Maidui3-lab/robo-con-Wi-Fi/Hardware/robo-con-Wi-Fi/robo-con-Wi-Fi.kicad_pcb

## KiCad design Hardware/robo-con-Wi-Fi/robo-con-Wi-Fi.kicad_pcb (2026-10-29)

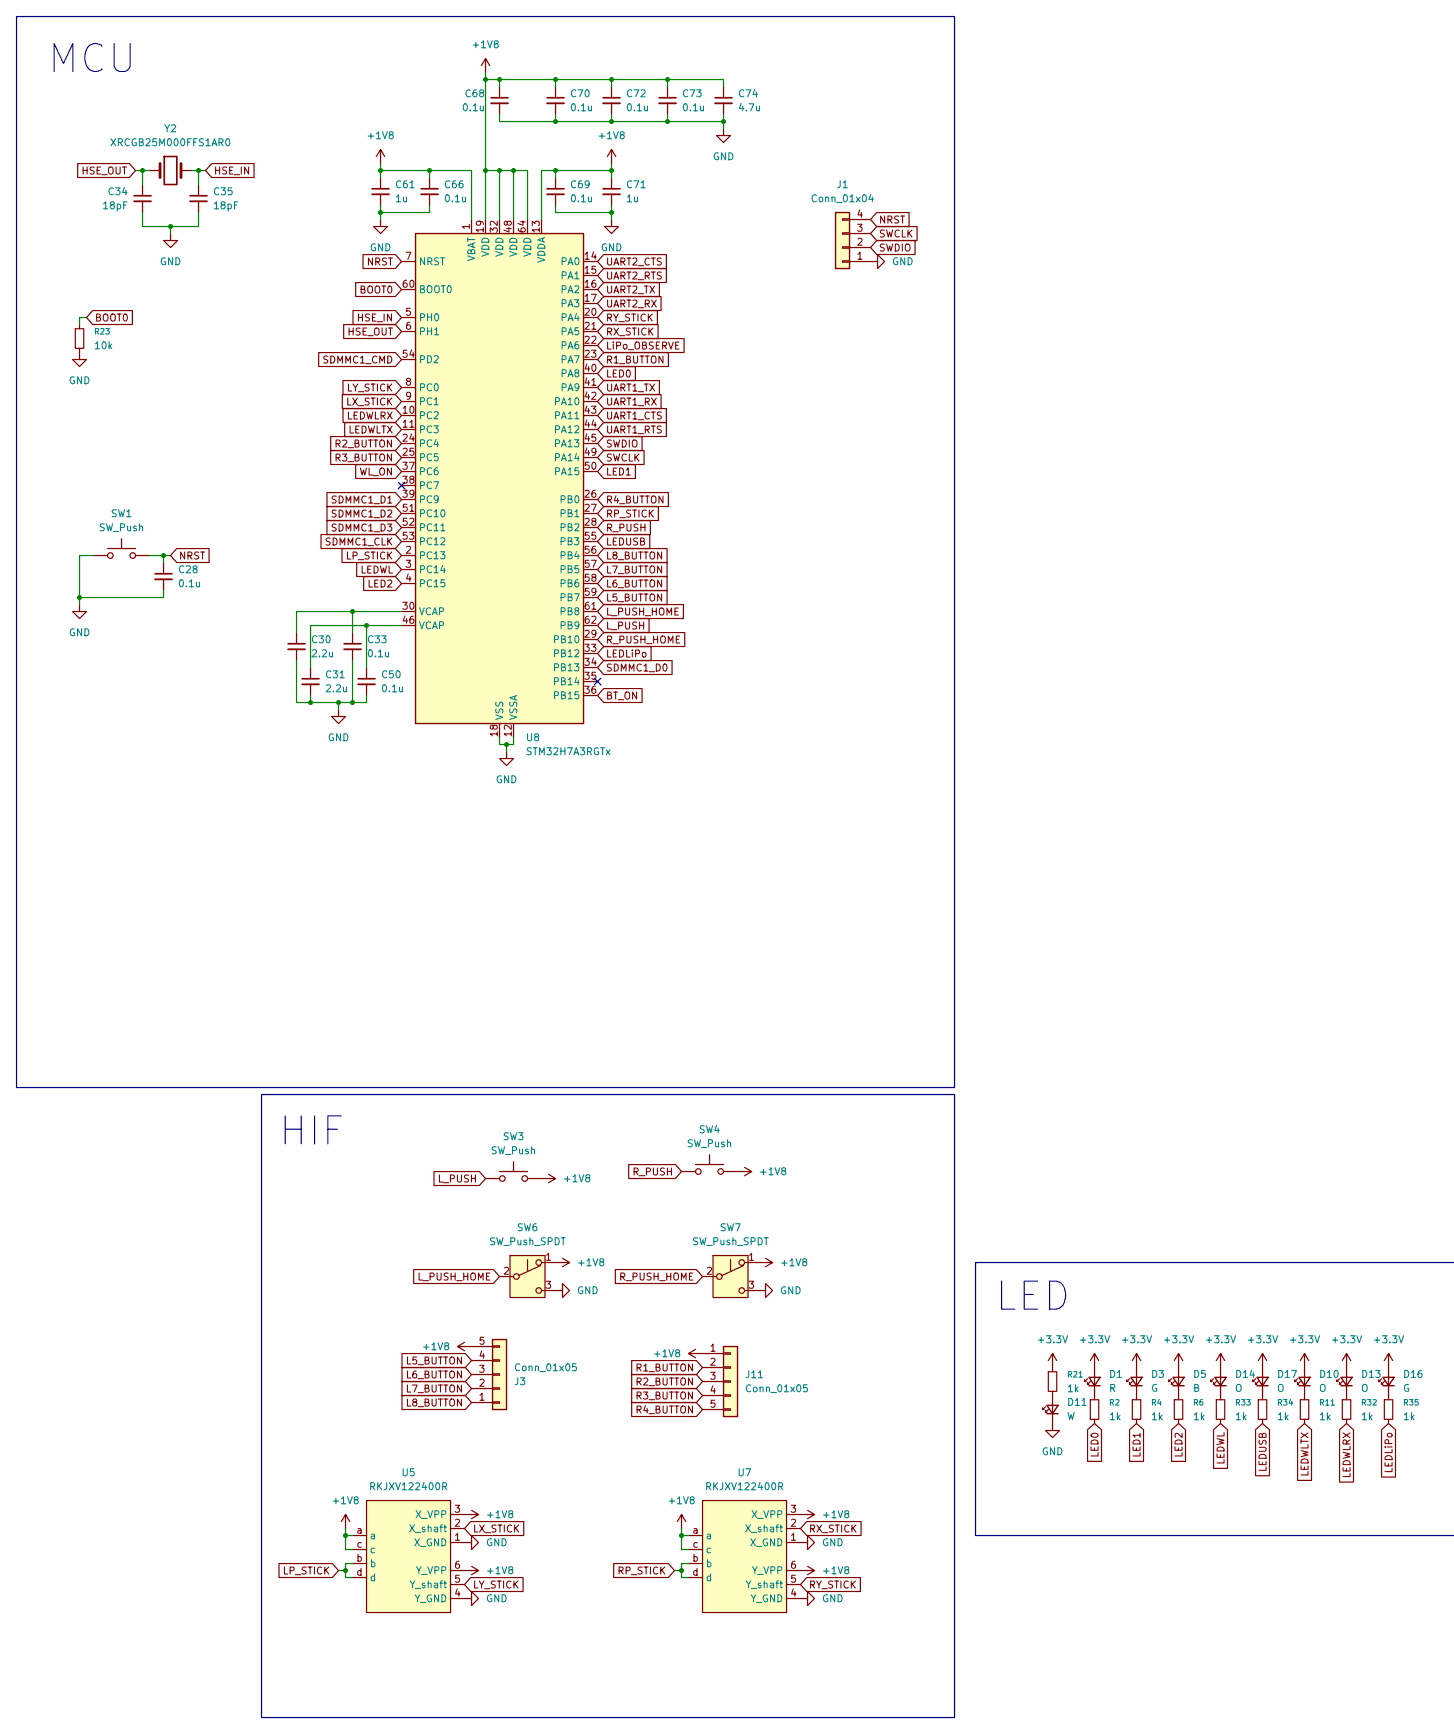
[picture p1: schematic robo-con-Wi-Fi.kicad_sch, part in row 1, column 1]

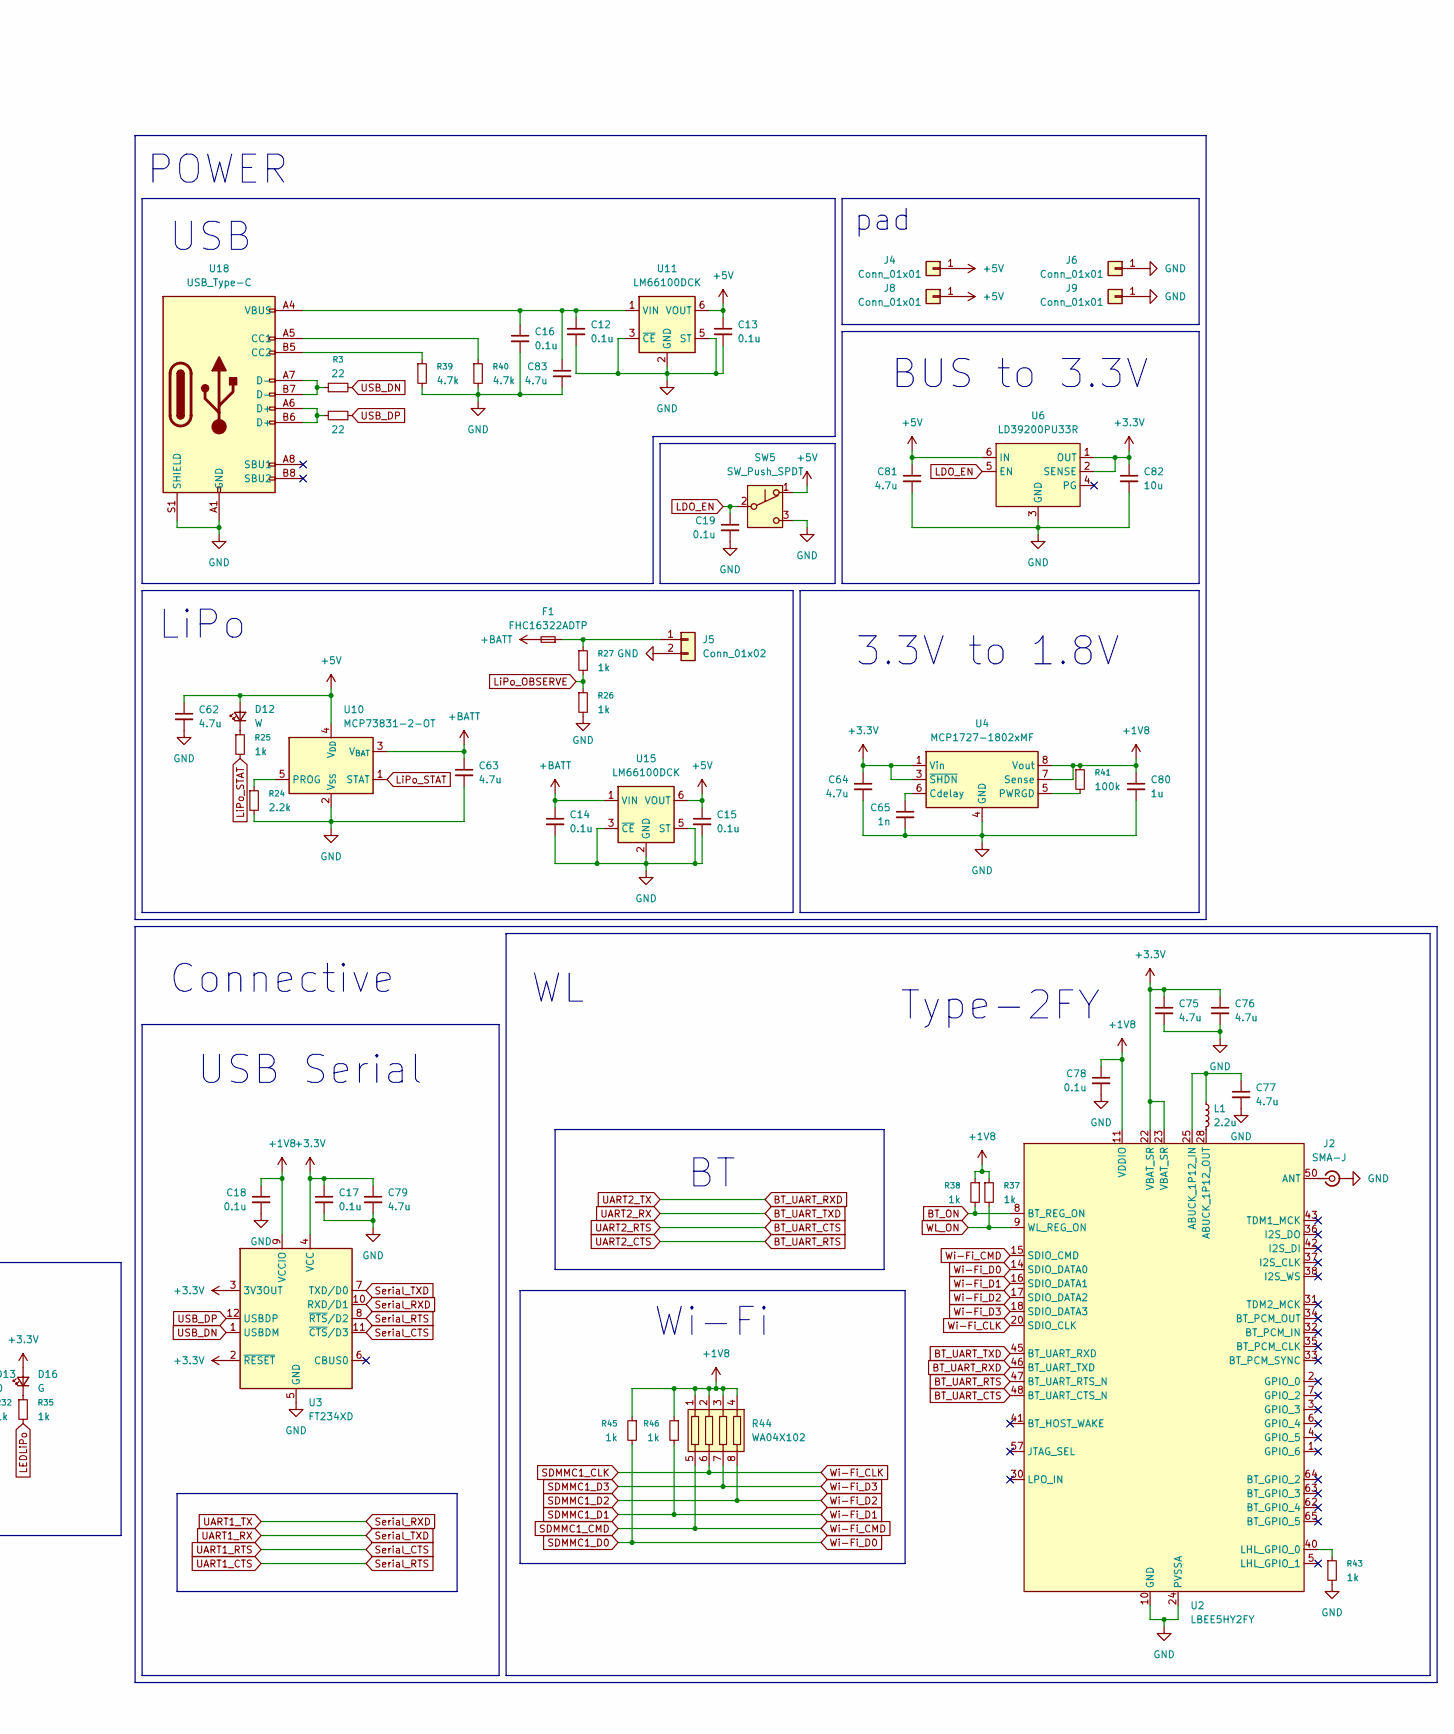
[picture p2: schematic robo-con-Wi-Fi.kicad_sch, part in row 1, column 2]

Parts:
C12, C13, C14, C15, C16, C17, C18, C19, C28, C33, C50, C66, C68, C69, C70, C72, C73, C78: 0.1u; C_0402_1005Metric_Pad0.74x0.62mm_HandSolder
C30, C31: 2.2u; C_0402_1005Metric_Pad0.74x0.62mm_HandSolder
C34, C35: 18pF; C_0402_1005Metric_Pad0.74x0.62mm_HandSolder
C61, C71, C80: 1u; C_0402_1005Metric_Pad0.74x0.62mm_HandSolder
C62, C63, C64, C74, C75, C76, C77, C79, C81, C83: 4.7u; C_0402_1005Metric_Pad0.74x0.62mm_HandSolder
C65: 1n; C_0402_1005Metric_Pad0.74x0.62mm_HandSolder
C82: 10u; C_0603_1608Metric_Pad1.08x0.95mm_HandSolder
D1: R; D_0603_1608Metric_Pad1.05x0.95mm_HandSolder
D3, D16: G; D_0603_1608Metric_Pad1.05x0.95mm_HandSolder
D5: B; D_0603_1608Metric_Pad1.05x0.95mm_HandSolder
D10, D13, D14, D17: O; D_0603_1608Metric_Pad1.05x0.95mm_HandSolder
D11, D12: W; D_0603_1608Metric_Pad1.05x0.95mm_HandSolder
F1: FHC16322ADTP; L_0603_1608Metric_Pad1.05x0.95mm_HandSolder
J1: Conn_01x04; PinSocket_1x04_P2.54mm_Vertical
J2: SMA-J; SMA_Conn
J3, J11: Conn_01x05; JST_ZH_B5B-ZR_1x05_P1.50mm_Vertical
J4, J6, J8, J9: Conn_01x01; SolderWirePad_1x01_SMD_1.5x3mm
J5: Conn_01x02; JST_PH_S2B-PH-K_1x02_P2.00mm_Horizontal
L1: 2.2u; L_1008_2520Metric_Pad1.43x2.20mm_HandSolder
R2, R4, R6, R11, R21, R25, R32, R33, R34, R35, R37, R38, R43, R45, R46: 1k; R_0402_1005Metric_Pad0.72x0.64mm_HandSolder
R3, R5: 22; R_0402_1005Metric_Pad0.72x0.64mm_HandSolder
R23: 10k; R_0402_1005Metric_Pad0.72x0.64mm_HandSolder
R24: 2.2k; R_0603_1608Metric_Pad0.98x0.95mm_HandSolder
R26, R27: 1k; R_0603_1608Metric_Pad0.98x0.95mm_HandSolder
R39, R40: 4.7k; R_0402_1005Metric_Pad0.72x0.64mm_HandSolder
R41: 100k; R_0603_1608Metric_Pad0.98x0.95mm_HandSolder
R44: WA04X102
SW1: SW_Push; switch_TVAF06-A020B-R
SW3, SW4: SW_Push; SKHHLPA010
SW5: SW_Push_SPDT; 4MS1R202M6QES
SW6, SW7: SW_Push_SPDT; 8MS8P1B05VS2QES-C13
U2: LBEE5HY2FY
U3: FT234XD; WDFN-12-1EP_3x3mm_P0.45mm_EP1.7x2.5mm
U4: MCP1727-1802xMF; DFN-8-1EP_3x3mm_P0.65mm_EP1.55x2.4mm
U5, U7: RKJXV122400R
U6: LD39200PU33R; DFN-6-1EP_3x3mm_P0.95mm_EP1.7x2.6mm
U8: STM32H7A3RGTx; LQFP-64_10x10mm_P0.5mm
U10: MCP73831-2-OT; SOT-23-5
U11, U15: LM66100DCK; SOT-363_SC-70-6
U18: USB_Type-C; USB_C_Receptacle_Nelton_5077CR-16-SMC2-BK-TR
Y2: XRCGB25M000FFS1AR0

Connections:
+1V8: C18.1, C61.1, C66.1, C68.1, C69.1, C70.1, C71.1, C72.1, C73.1, C74.1, C78.1, C80.1, J3.5, J11.1, R37.1, R38.1, R41.1, R44.1, R44.2, R44.3, R44.4, R45.1, R46.1, SW3.2, SW4.2, SW6.1 (A), SW7.1 (A), U2.11 (VDDIO), U3.9 (VCCIO), U4.7 (Sense), U4.8 (Vout), U5.3 (X_VPP), U5.6 (Y_VPP), U5.a, U5.c, U7.3 (X_VPP), U7.6 (Y_VPP), U7.a, U7.c, U8.1 (VBAT), U8.13 (VDDA), U8.19 (VDD), U8.32 (VDD), U8.48 (VDD), U8.64 (VDD)
+3.3V: C17.1, C64.1, C75.1, C76.1, C79.1, C82.1, D1.2 (A), D3.2 (A), D5.2 (A), D10.2 (A), D13.2 (A), D14.2 (A), D16.2 (A), D17.2 (A), R21.1, U2.22 (VBAT_SR), U2.23 (VBAT_SR), U3.2 (~RESET), U3.3 (3V3OUT), U3.4 (VCC), U4.1 (Vin), U4.2 (Vin), U4.3 (~SHDN), U6.1 (OUT), U6.2 (SENSE)
+5V: C13.1, C15.1, C62.1, C81.1, D12.2 (A), J4.1 (Pin_1_1), J8.1 (Pin_1_1), SW5.1 (A), U6.6 (IN), U10.4 (V_{DD}), U11.6 (VOUT), U15.6 (VOUT)
+BATT: C14.1, C63.1, F1.2, U10.3 (V_{BAT}), U15.1 (VIN)
BOOT0: R23.1, U8.60 (BOOT0)
BT_ON: R38.2, U2.8 (BT_REG_ON), U8.36 (PB15)
BT_UART_CTS: U2.48 (BT_UART_CTS_N), U8.15 (PA1)
BT_UART_RTS: U2.47 (BT_UART_RTS_N), U8.14 (PA0)
BT_UART_RXD: U2.46 (BT_UART_TXD), U8.16 (PA2)
BT_UART_TXD: U2.45 (BT_UART_RXD), U8.17 (PA3)
GND: C12.2, C13.2, C14.2, C15.2, C16.2, C17.2, C18.2, C19.2, C28.2, C30.2, C31.2, C33.2, C34.2, C35.2, C50.2, C61.2, C62.2, C63.2, C64.2, C65.2, C66.2, C68.2, C69.2, C70.2, C71.2, C72.2, C73.2, C74.2, C75.2, C76.2, C77.2, C78.2, C79.2, C80.2, C81.2, C82.2, C83.2, D11.1 (K), J1.1, J2.2 (Ext), J5.2, J6.1 (Pin_1_1), J9.1 (Pin_1_1), R23.2, R24.2, R26.2, R39.2, R40.2, R43.2, SW1.1, SW5.3 (C), SW6.3 (C), SW7.3 (C), U2.10 (GND), U2.12 (GND), U2.13 (GND), U2.19 (GND), U2.21 (GND), U2.24 (PVSSA), U2.26 (PVSSA), U2.27 (PVSSA), U2.29 (GND), U2.39 (GND), U2.44 (GND), U2.49 (GND), U2.51 (GND), U2.52 (GND), U2.53 (GND), U2.55 (GND), U2.56 (GND), U2.58 (GND), U2.59 (GND), U2.60 (GND), U2.61 (GND), U2.66 (GND), U2.67 (GND), U2.68 (GND), U2.69 (GND), U2.70 (GND), U2.71 (GND), U2.72 (GND), U3.5 (GND), U3.13 (GND), U4.4 (GND), U4.9 (GND), U5.1 (X_GND), U5.4 (Y_GND), U6.3 (GND), U6.7 (GND), U7.1 (X_GND), U7.4 (Y_GND), U8.12 (VSSA), U8.18 (VSS), U8.31 (VSS), U8.47 (VSS), U8.63 (VSS), U10.2 (V_{SS}), U11.2 (GND), U11.3 (~CE), U11.5 (ST), U15.2 (GND), U15.3 (~CE), U15.5 (ST), U18.A1 (GND), U18.B1 (GND), U18.S1 (SHIELD)
HSE_IN: C35.1, U8.5 (PH0), Y2.3 (2)
HSE_OUT: C34.1, U8.6 (PH1), Y2.1
L5_BUTTON: J3.4, U8.59 (PB7)
L6_BUTTON: J3.3, U8.58 (PB6)
L7_BUTTON: J3.2, U8.57 (PB5)
L8_BUTTON: J3.1, U8.56 (PB4)
LDO_EN: C19.1, SW5.2 (B), U6.5 (EN)
LED0: R2.2, U8.40 (PA8)
LED1: R4.2, U8.50 (PA15)
LED2: R6.2, U8.4 (PC15)
LEDLiPo: R35.2, U8.33 (PB12)
LEDUSB: R34.2, U8.55 (PB3)
LEDWL: R33.2, U8.3 (PC14)
LEDWLRX: R32.2, U8.10 (PC2)
LEDWLTX: R11.2, U8.11 (PC3)
LP_STICK: U5.b, U5.d, U8.2 (PC13)
LX_STICK: U5.2 (X_shaft), U8.9 (PC1)
LY_STICK: U5.5 (Y_shaft), U8.8 (PC0)
L_PUSH: SW3.1, U8.62 (PB9)
L_PUSH_HOME: SW6.2 (B), U8.61 (PB8)
LiPo_OBSERVE: R26.1, R27.2, U8.22 (PA6)
LiPo_STAT: R25.2, U10.1 (STAT)
NRST: C28.1, J1.4, SW1.2, U8.7 (NRST)
unnamed: C30.1, C33.1, U8.30 (VCAP)
unnamed: C31.1, C50.1, U8.46 (VCAP)
unnamed: D1.1 (K), R2.1
unnamed: D3.1 (K), R4.1
unnamed: D5.1 (K), R6.1
unnamed: D10.1 (K), R11.1
unnamed: D11.2 (A), R21.2
unnamed: D12.1 (K), R25.1
unnamed: D13.1 (K), R32.1
unnamed: D14.1 (K), R33.1
unnamed: D16.1 (K), R35.1
unnamed: D17.1 (K), R34.1
unnamed: J2.1 (In), U2.50 (ANT)
unnamed: F1.1, J5.1, R27.1
unnamed: R3.1, U18.A7 (D-), U18.B7 (D-)
unnamed: R5.1, U18.A6 (D+), U18.B6 (D+)
unnamed: C77.1, L1.1, U2.25 (ABUCK_1P12_IN)
unnamed: L1.2, U2.28 (ABUCK_1P12_OUT)
unnamed: R43.1, U2.40 (LHL_GPIO_0)
unnamed: C65.1, U4.6 (Cdelay)
unnamed: R41.2, U4.5 (PWRGD)
unnamed: R24.1, U10.5 (PROG)
unnamed: C12.1, C16.1, C83.1, U11.1 (VIN), U18.A4 (VBUS), U18.B4 (VBUS)
unnamed: R40.1, U18.A5 (CC1)
unnamed: R39.1, U18.B5 (CC2)
R1_BUTTON: J11.2, U8.23 (PA7)
R2_BUTTON: J11.3, U8.24 (PC4)
R3_BUTTON: J11.4, U8.25 (PC5)
R4_BUTTON: J11.5, U8.26 (PB0)
RP_STICK: U7.b, U7.d, U8.27 (PB1)
RX_STICK: U7.2 (X_shaft), U8.21 (PA5)
RY_STICK: U7.5 (Y_shaft), U8.20 (PA4)
R_PUSH: SW4.1, U8.28 (PB2)
R_PUSH_HOME: SW7.2 (B), U8.29 (PB10)
SDMMC1_CLK: R44.6, U2.20 (SDIO_CLK), U8.53 (PC12)
SDMMC1_CMD: R44.5, U2.15 (SDIO_CMD), U8.54 (PD2)
SDMMC1_D0: R45.2, U2.14 (SDIO_DATA0), U8.34 (PB13)
SDMMC1_D1: R46.2, U2.16 (SDIO_DATA1), U8.39 (PC9)
SDMMC1_D2: R44.8, U2.17 (SDIO_DATA2), U8.51 (PC10)
SDMMC1_D3: R44.7, U2.18 (SDIO_DATA3), U8.52 (PC11)
SWCLK: J1.3, U8.49 (PA14)
SWDIO: J1.2, U8.45 (PA13)
Serial_CTS: U3.11 (~CTS/D3), U8.44 (PA12)
Serial_RTS: U3.8 (~RTS/D2), U8.43 (PA11)
Serial_RXD: U3.10 (RXD/D1), U8.41 (PA9)
Serial_TXD: U3.7 (TXD/D0), U8.42 (PA10)
USB_DN: R3.2, U3.1 (USBDM)
USB_DP: R5.2, U3.12 (USBDP)
WL_ON: R37.2, U2.9 (WL_REG_ON), U8.37 (PC6)

Notes on the sheet:
Connective
pad
Type-2FY
USB Serial
USB
LiPo
BUS to 3.3V
Wi-Fi
POWER
LED
3.3V to 1.8V
MCU
HIF

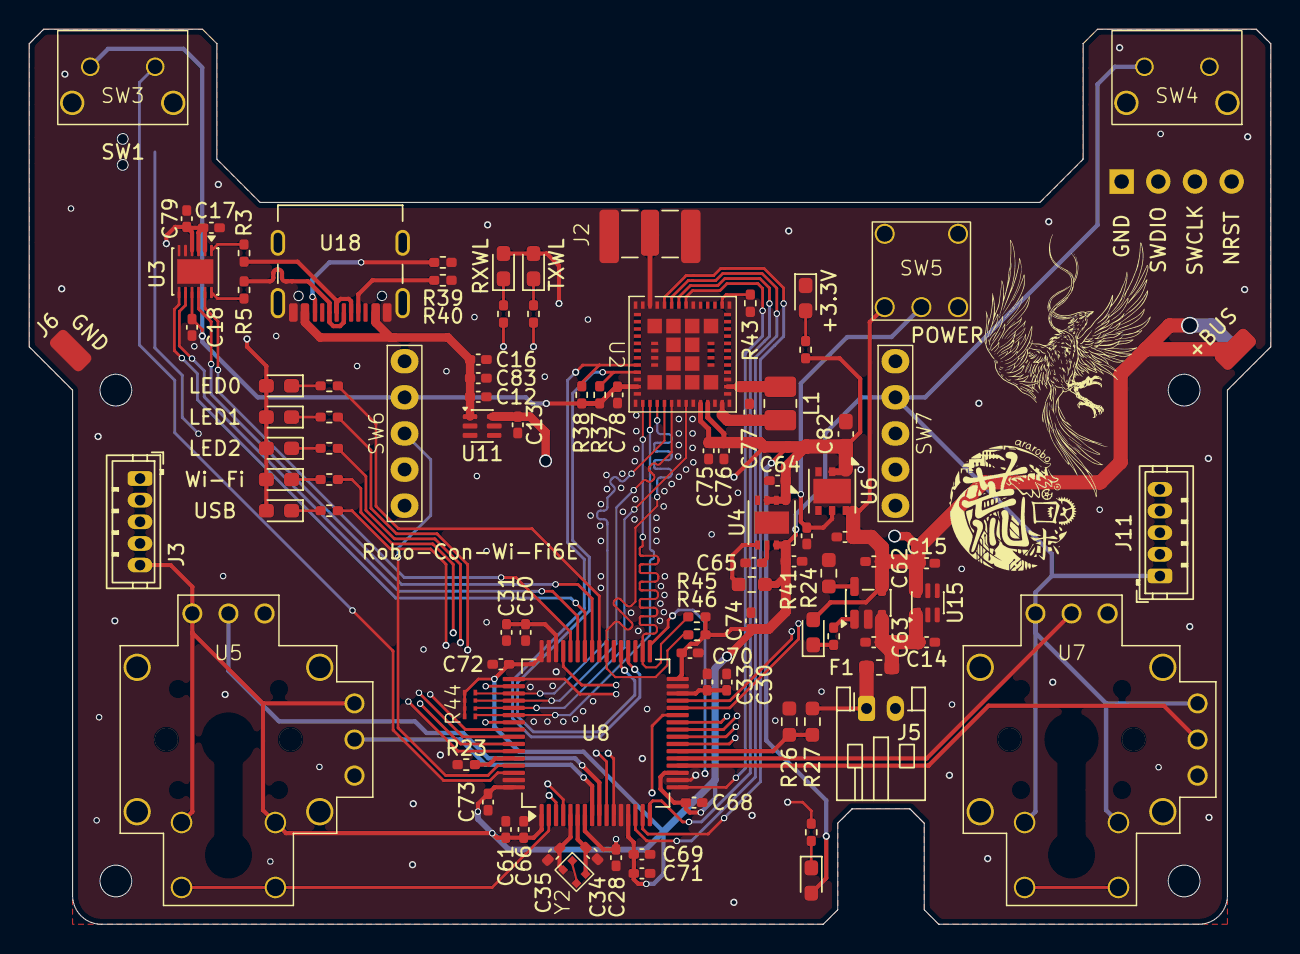
[picture p3: board robo-con-Wi-Fi.kicad_pcb from above]

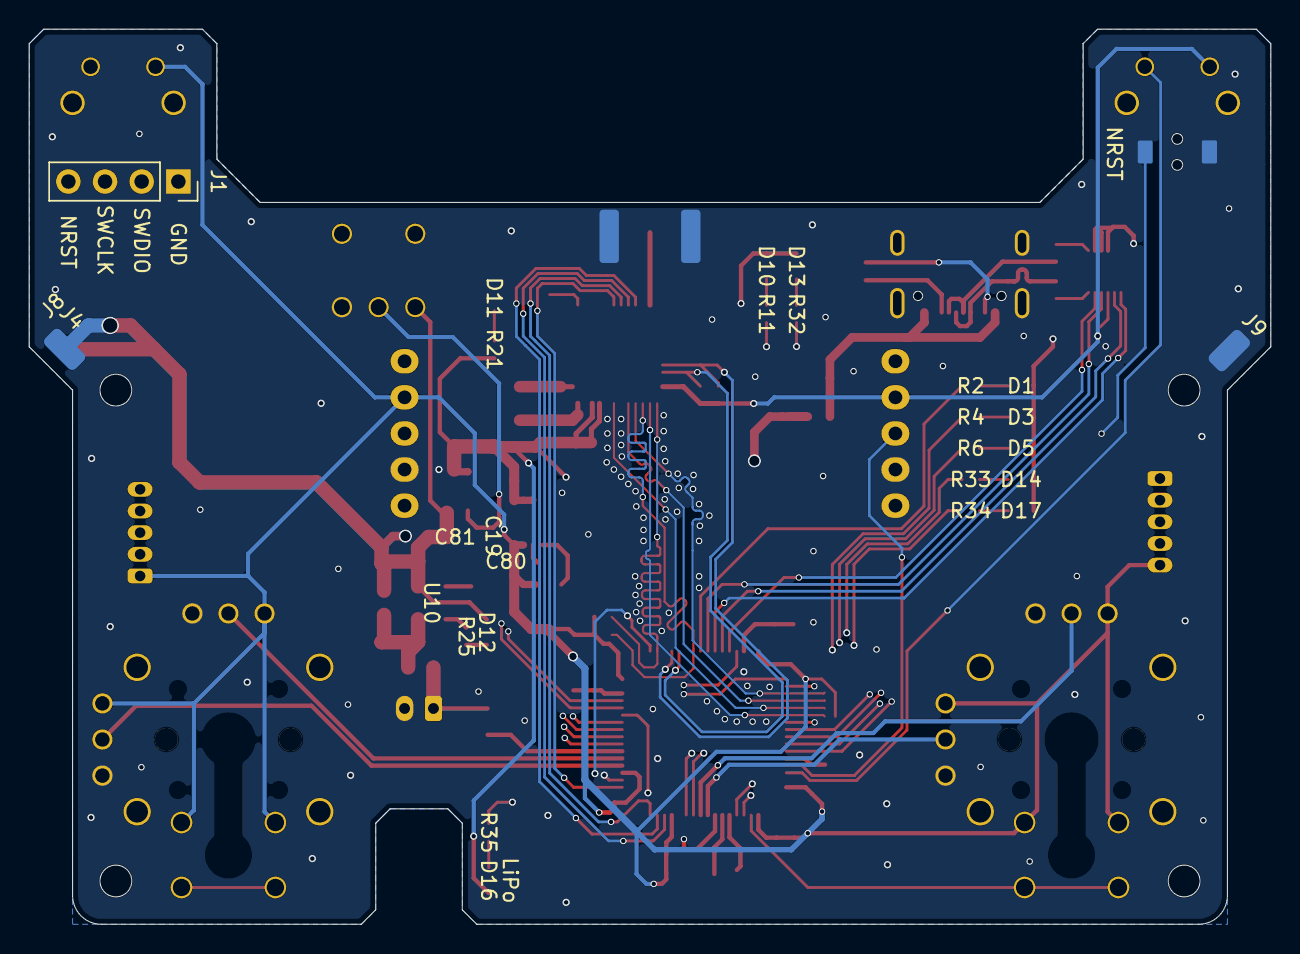
[picture p4: board robo-con-Wi-Fi.kicad_pcb from below]

Board: 4 copper layers, 86.0 x 62.0 mm, 101 parts (4 on the bottom side), 83 nets.
