Maidui3-lab/robo-con-Wi-Fi/Firmware/robo-con-Wi-Fi-v2.ioc

Mcu.UserName=STM32H7A3RGTx
PA0.Signal=USART2_CTS
PA1.Signal=USART2_RTS
PA10.Signal=USART1_RX
PA11.Signal=USART1_CTS
PA12.Signal=USART1_RTS
PA13.Signal=DEBUG_JTMS-SWDIO
PA14.Signal=DEBUG_JTCK-SWCLK
PA15.GPIO_Label=LED1
PA15.Signal=GPIO_Output
PA2.Signal=USART2_TX
PA3.Signal=USART2_RX
PA4.Signal=ADCx_INP18
PA5.Signal=ADCx_INP19
PA6.Signal=ADCx_INP3
PA7.GPIO_Label=R1_BUTTON
PA7.Signal=GPIO_Input
PA8.GPIO_Label=LED0
PA8.Signal=GPIO_Output
PA9.Signal=USART1_TX
PB0.GPIO_Label=R4_BUTTON
PB0.Signal=GPIO_Input
PB1.GPIO_Label=RP_STICK
PB1.Signal=GPIO_Input
PB10.GPIO_Label=R_PUSH_HOME
PB10.Signal=GPIO_Input
PB12.GPIO_Label=LEDLiPo
PB12.Signal=GPIO_Output
PB13.Signal=SDMMC1_D0
PB15.GPIO_Label=BT_ON
PB15.Signal=GPIO_Output
PB2.GPIO_Label=R_PUSH
PB2.Signal=GPIO_Input
PB3.GPIO_Label=LEDUSB
PB3.Signal=GPIO_Output
PB4.GPIO_Label=L8_BUTTON
PB4.Signal=GPIO_Input
PB5.GPIO_Label=L7_BUTTON
PB5.Signal=GPIO_Input
PB6.GPIO_Label=L6_BUTTON
PB6.Signal=GPIO_Input
PB7.GPIO_Label=L5_BUTTON
PB7.Signal=GPIO_Input
PB8.GPIO_Label=L_PUSH_HOME
PB8.Signal=GPIO_Input
PB9.GPIO_Label=L_PUSH
PB9.Signal=GPIO_Input
PC0.Signal=ADCx_INP10
PC1.Signal=ADCx_INP11
PC10.Signal=SDMMC1_D2
PC11.Signal=SDMMC1_D3
PC12.Signal=SDMMC1_CK
PC13.GPIO_Label=LP_STICK
PC13.Signal=GPIO_Input
PC14-OSC32_IN.GPIO_Label=LEDWL
PC14-OSC32_IN.Signal=GPIO_Output
PC15-OSC32_OUT.GPIO_Label=LED2
PC15-OSC32_OUT.Signal=GPIO_Output
PC2.GPIO_Label=LEDWLRX
PC2.Signal=GPIO_Output
PC3.GPIO_Label=LEDWLTX
PC3.Signal=GPIO_Output
PC4.GPIO_Label=R2_BUTTON
PC4.Signal=GPIO_Input
PC5.GPIO_Label=R3_BUTTON
PC5.Signal=GPIO_Input
PC6.GPIO_Label=WL_ON
PC6.Signal=GPIO_Output
PC9.Signal=SDMMC1_D1
PD2.Signal=SDMMC1_CMD
PH0-OSC_IN.Signal=RCC_OSC_IN
PH1-OSC_OUT.Signal=RCC_OSC_OUT
