Maidui3-lab/robo-con-Wi-Fi/Firmware/app/src/printf.c

#include "app/printf.h"
//
#include "main.h"
#include "usart.h"
//
#include "tx_api.h"
//
#include "app/robo-con.h"

#define CDC_MAX_TRANSPORT_SIZE 512

#define USB_TX_BUFFER_SIZE CDC_MAX_TRANSPORT_SIZE * 16U
__attribute__RAM_D1__BSS__ uint8_t TX_Buffer[USB_TX_BUFFER_SIZE];
__attribute__DTCM__BSS__ uint8_t RX_Buffer[2048];
__attribute__DTCM__BSS__ uint16_t Buffer_len;
__attribute__DTCM__BSS__ uint16_t tx_start_point;
__attribute__DTCM__BSS__ uint16_t rest;
__attribute__DTCM__BSS__ bool Tramsmit_request;
__attribute__DTCM__BSS__ bool tx_cplt;

__attribute__RAM_D1__BSS__ uint8_t ex_tx[] = "SETUP CDC Thread";

__attribute__DTCM__ TX_THREAD CDC_Thread;

__attribute__ITCM__ void CDC_thread(ULONG thred_input);

#define CDC_APP_STACK_SIZE                  512
#define CDC_APP_THREAD_PRIO                 10
#define CDC_APP_THREAD_PREEMPTION_THRESHOLD CDC_APP_THREAD_PRIO
#define CDC_APP_THREAD_TIME_SLICE           TX_NO_TIME_SLICE
#define CDC_APP_THREAD_AUTO_START           TX_AUTO_START
#define CDC_APP_THREAD_DONT_START           TX_DONT_START

UINT cdc_init(VOID *memory_ptr) {
  TX_BYTE_POOL *byte_pool = (TX_BYTE_POOL *)memory_ptr;

  CHAR *pointer;

  if (tx_byte_allocate(byte_pool, (VOID **)&pointer, CDC_APP_STACK_SIZE, TX_NO_WAIT) !=
      TX_SUCCESS) {
    printf("cdc pool allocate error\r\n");
    return CDC_POOLERROR;
  }

  if (tx_thread_create(
          &CDC_Thread,
          "CDC Thread",
          CDC_thread,
          0,
          pointer,
          CDC_APP_STACK_SIZE,
          CDC_APP_THREAD_PRIO,
          CDC_APP_THREAD_PREEMPTION_THRESHOLD,
          CDC_APP_THREAD_TIME_SLICE,
          CDC_APP_THREAD_AUTO_START
      )) {
    printf("cdc thread initializing error\r\n");
    return CDC_THREAD_ERROR;
  }

  HAL_UART_Transmit_DMA(&huart1, ex_tx, sizeof(ex_tx));

  return CDC_SUCCSES;
}

void CDC_thread(ULONG thred_input) {
  while (1) {
    __enable_irq();

    HAL_GPIO_TogglePin(LEDUSB_GPIO_Port, LEDUSB_Pin);

    if (Tramsmit_request && tx_cplt) {

      if (tx_start_point > Buffer_len) {
        HAL_UART_Transmit_DMA(&huart1, &TX_Buffer[tx_start_point], rest);
        tx_start_point = 0;
        tx_cplt        = false;
      } else {
        HAL_UART_Transmit_DMA(&huart1, &TX_Buffer[tx_start_point], Buffer_len);
        tx_start_point   = Buffer_len;
        tx_cplt          = false;
        Tramsmit_request = false;
      }
    }

    tx_thread_sleep(50);
  };
}

int _write(int file, char *ptr, int len) {
  static uint16_t size;

  size           = Buffer_len + len;
  tx_start_point = Buffer_len;

  if (size > USB_TX_BUFFER_SIZE) {
    Buffer_len = size - USB_TX_BUFFER_SIZE;
    rest       = USB_TX_BUFFER_SIZE - tx_start_point;

    for (uint16_t i = 0; i < rest; i++) {
      TX_Buffer[tx_start_point + i] = ptr[i];
    }
    for (uint16_t i = 0; i < Buffer_len; i++) {
      TX_Buffer[i] = ptr[i + rest];
    }
  } else {
    for (uint16_t i = 0; i < len; i++) {
      TX_Buffer[tx_start_point + i] = ptr[i];
    }
    Buffer_len += len;
  }
  Buffer_len += 1;

  Tramsmit_request = true;

  return len;
}

void print_tx_cplt(UART_HandleTypeDef *huart) {
  if (huart == &huart1) {
    tx_cplt = true;
  }
}
