Maidui3-lab/robo-con-Wi-Fi/(commit log)

2026-10-29 uprode PCB files
    [robo-con-Wi-Fi.kicad_pcb, robo-con-Wi-Fi.kicad_sch]
2026-10-30 .gitignoreにbuildディレクトリを追加し、複数のファイルでコードの整形と修正を行いました。新しい関数を追加し、変数のスコープを調整しました。
2026-10-30 tls エラーの解決
2026-10-30 printf.cとrobo-con.cppのコードを整形し、CDCおよびrobo-conスレッドの初期化処理を改善しました。また、.clang-formatファイルを追加しました。
2026-10-31 printfの実装
2026-10-31 関数のインラインについて
2026-11-01 printfのデバッグ
2026-11-03 USB_TX_BUFFER_SIZEの定義をCDC_MAX_TRANSPORT_SIZEに基づいて修正し、不要な定義を削除しました。
2026-11-04 startupのファイル変更
2026-11-06 D2, D3のbssの動作がおかしい。 RAM_FUNCで動かしているためDMAが割り込めずにいるためADCの値が変わらないはず
2026-11-07 bssセクションの.bss*による複数のセクションのかぶりを修正
2026-11-07 CMAKE_PROJECT_NAMEの変更
